ioquatix/zonestar-p802q-bracing/build/fan-holder.stl

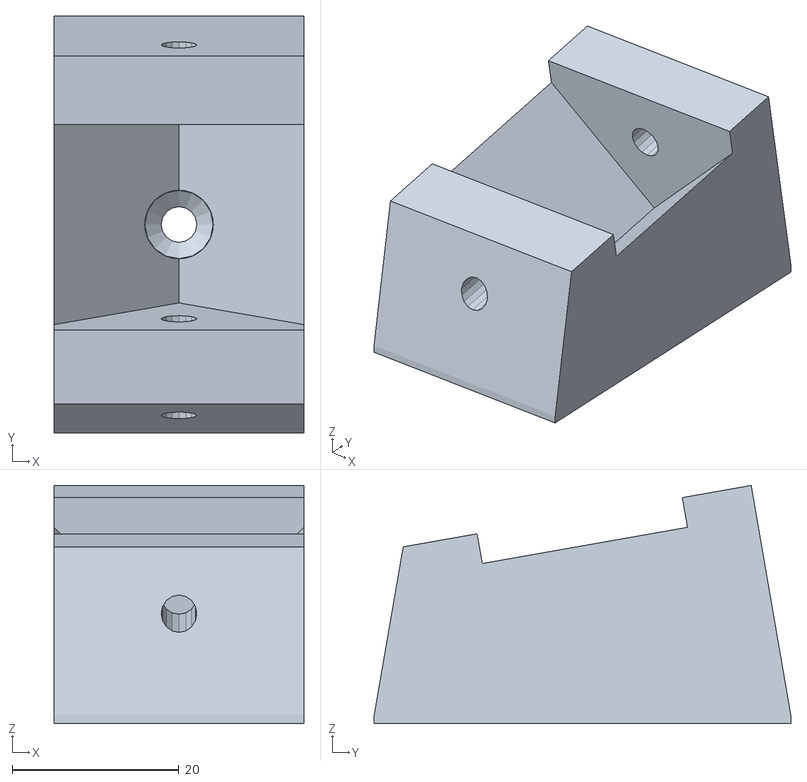
[picture p4: CAD file, 2020-12-01]
build/fan-holder.stl
30.0 x 50.0 x 28.6
