ioquatix/zonestar-p802q-bracing/build/clamp.stl

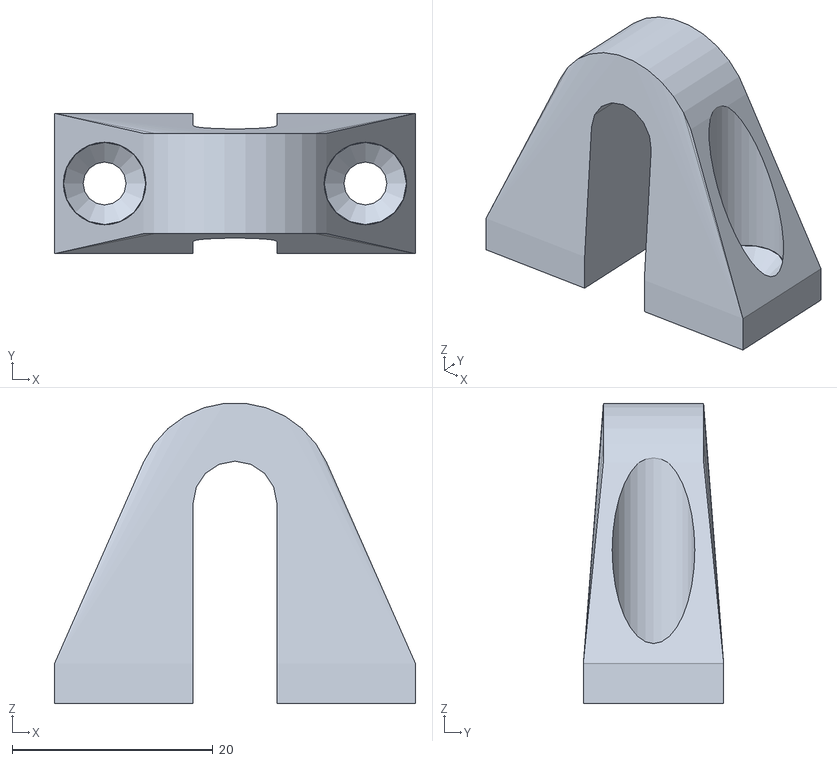
[picture p5: CAD file, 2017-12-16]
build/clamp.stl
36.0 x 14.0 x 29.9
