ioquatix/zonestar-p802q-bracing/(list of files, cad)

Other CAD files:
source/zcube.scad
