ioquatix/zonestar-p802q-bracing/(commit log)

2016-05-31 Final parts printed.
    [bolts.scad, front-support.scad, test-bolts.scad, z-axis-platform.scad]
2017-12-16 Add clamp for clamping printer down to table/board.
    [bolts.scad, clamp.scad, clamp.stl, front-support.scad, test-bolts.scad, z-axis-platform.scad]
2017-12-16 Stronger clamps.
    [clamp.scad, clamp.stl]
2020-12-01 Add fan holder for cooling PCB.
    [fan-holder.scad, fan-holder.stl, zcube.scad]
